bschan9228/WaterWeather/README.md

# WaterWeather
Projects involving aquariums
