bschan9228/WaterWeather/WaterTopper/README.md

# WaterTopper
WaterTopper is a device that can automatically pump liquids. Using non-contact liquid level sensors, it can pump water accordingly.

It features:
- ESP32-S3-MINI-1 microcontroller
- USB-C for programming and powering the device
- Barrel jack to power two motors through terminals
- Dual motor drivers to control peristaltic pumps
- Four JST connectors to connect non-contact liquid level sensors
- 240x320 TFT display
- External temperature sensor
- One user-programmable button
- Six user-programmable LEDs




## Schematics


## PCB Design
WaterTopper_PCB

## Current Hardware Bugs
- Display's MOSFET has the wrong pinout/footprint
- Display's connectors has the wrong size/footprint
- JST connectors have the wrong footprint

- Significant problems with motor driver not working
- Voltage divider dividing incorrectly

Thanks for UCSD Envision/Colin for making this project happen.
