bschan9228/WaterWeather/WaterTopper/Hardware/esp32s3.png

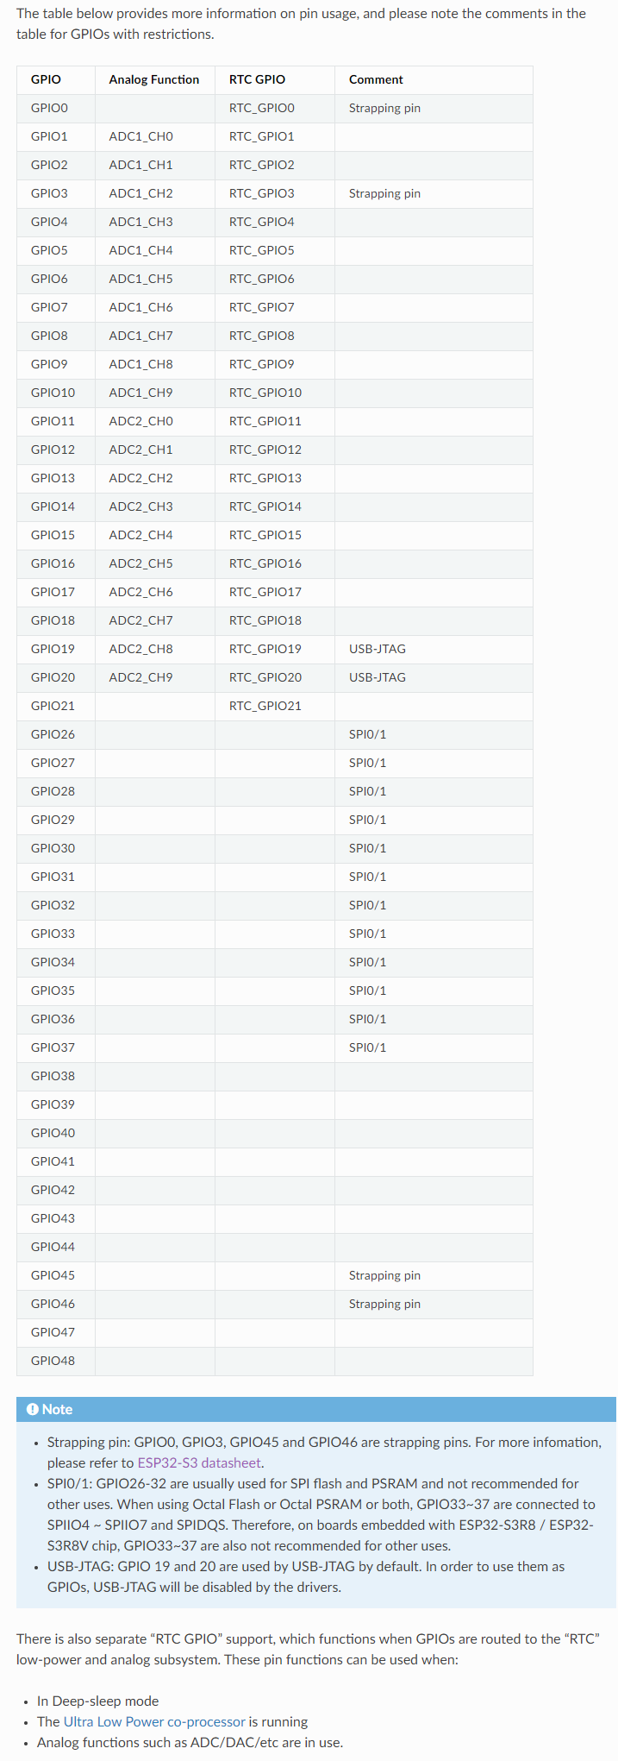
WaterTopper/Hardware/esp32s3.png
