bschan9228/WaterWeather/WaterTopper/Hardware/WaterTopper/WaterTopper.kicad_pcb

## KiCad design WaterTopper/Hardware/WaterTopper/WaterTopper.kicad_pcb (2022-11-21)

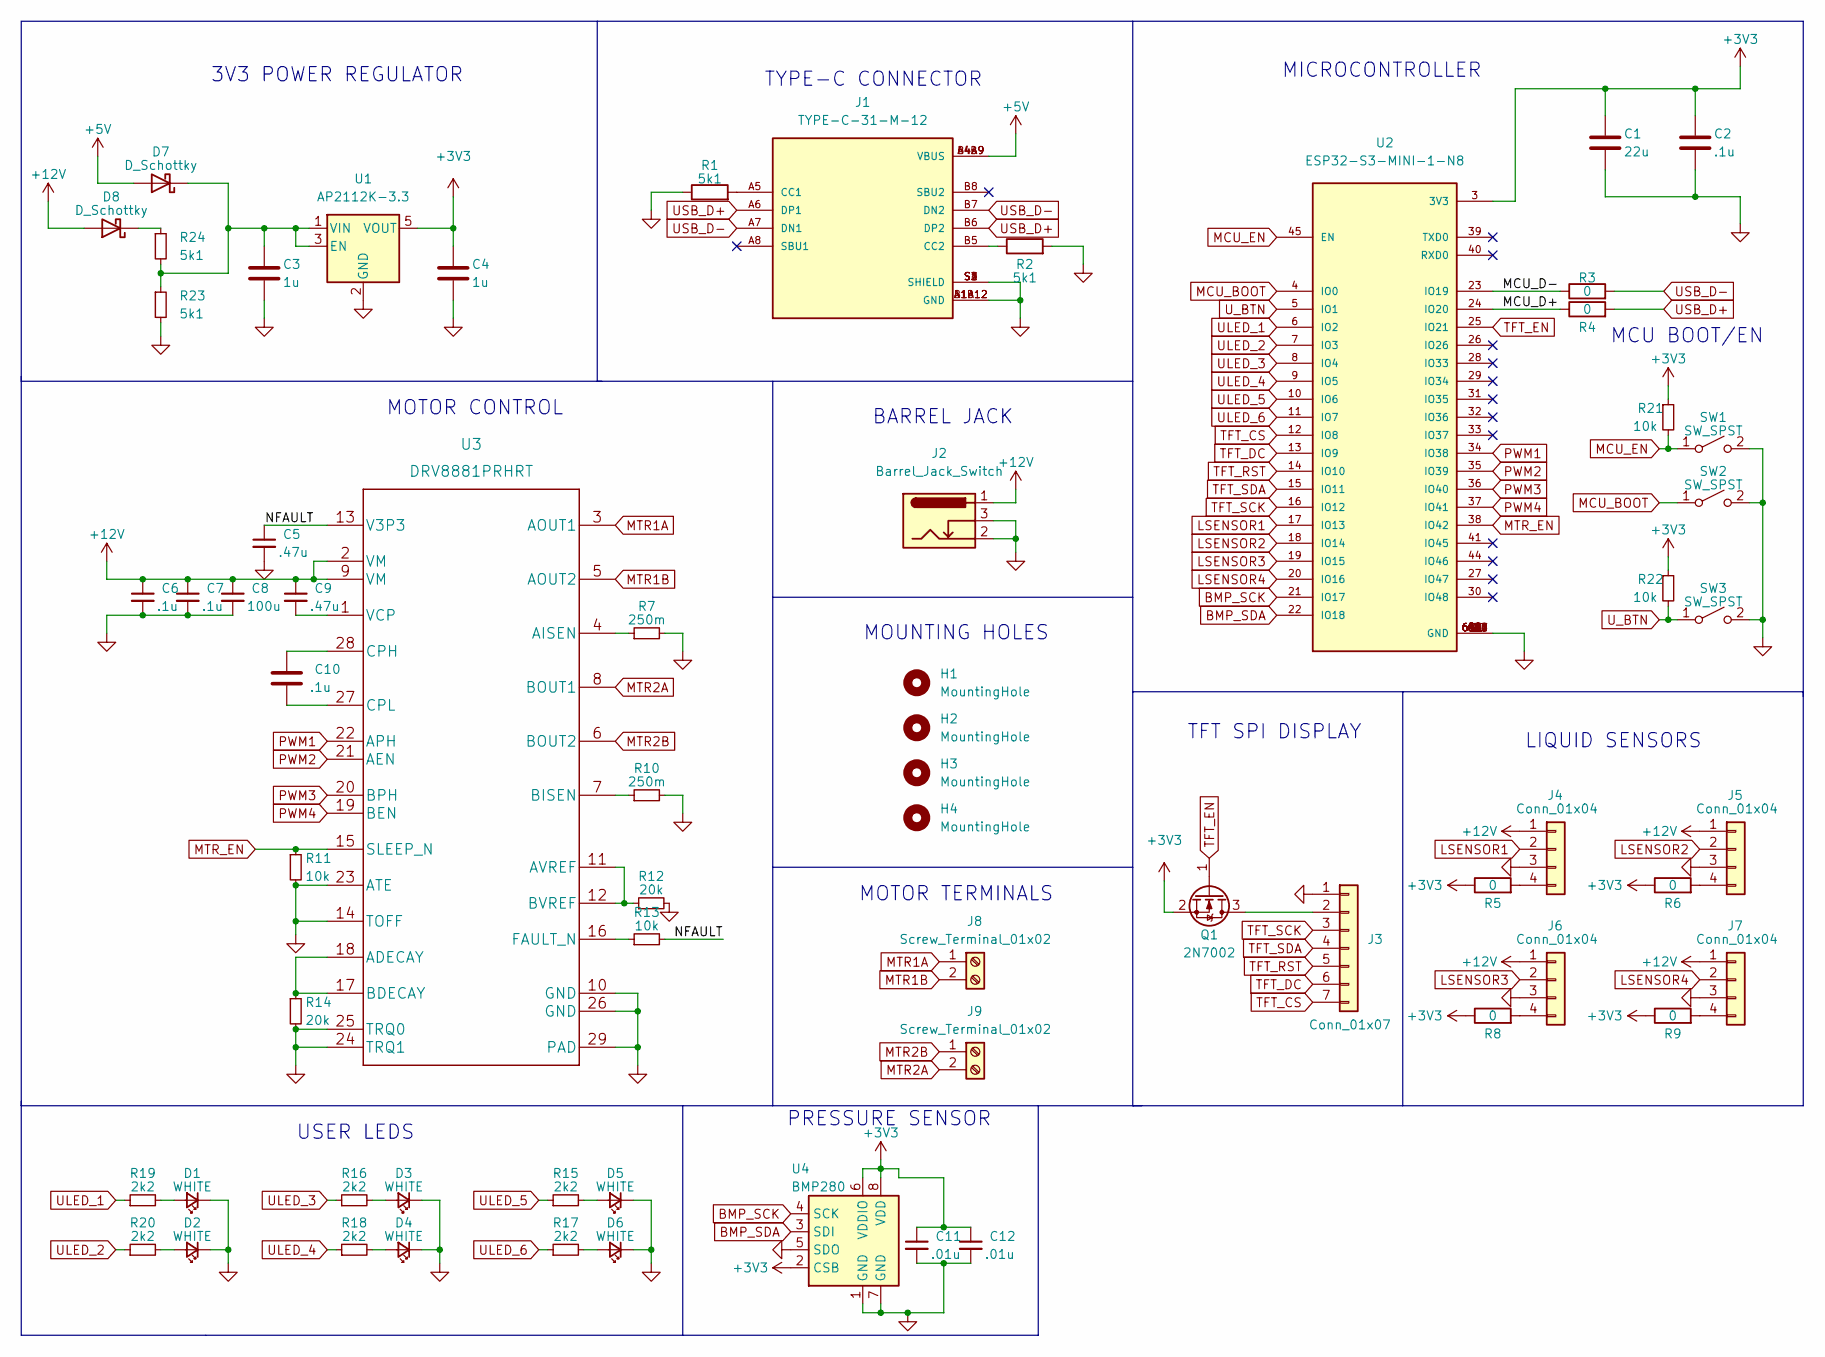
[picture p2: schematic WaterTopper.kicad_sch]

Parts:
C1: 22u; C_0805_2012Metric
C2, C6, C7, C10: .1u; C_0603_1608Metric
C3, C4: 1u; C_0805_2012Metric
C5, C9: .47u; C_0603_1608Metric
C8: 100u; C_Elec_6.3x5.8
C11, C12: .01u; C_0603_1608Metric
D1, D2, D3, D4, D5, D6: WHITE; LED_0603_1608Metric
D7, D8: D_Schottky; D_SMA
H1, H2, H3, H4: MountingHole; MountingHole_3.2mm_M3
J1: TYPE-C-31-M-12; HRO_TYPE-C-31-M-12; PARTREV A
J2: Barrel_Jack_Switch; BarrelJack_Wuerth_6941xx301002
J3: Conn_01x07; PinHeader_1x07_P2.00mm_Vertical
J4, J5, J6, J7: Conn_01x04; JST_PH_B4B-PH-K_1x04_P2.00mm_Vertical
J8, J9: Screw_Terminal_01x02; TerminalBlock_bornier-2_P5.08mm
Q1: 2N7002; SOT-23
R1, R2, R23, R24: 5k1; R_0603_1608Metric
R3, R4, R5, R6, R8, R9: 0; R_0603_1608Metric
R7, R10: 250m; R_0603_1608Metric
R11, R13, R21, R22: 10k; R_0603_1608Metric
R12, R14: 20k; R_0603_1608Metric
R15, R16, R17, R18, R19, R20: 2k2; R_0603_1608Metric
SW1, SW2: SW_SPST; SW_SPST_PTS810
SW3: SW_SPST; SW_Tactile_SPST_Angled_PTS645Vx58-2LFS
U1: AP2112K-3.3; SOT-23-5
U2: ESP32-S3-MINI-1-N8; XCVR_ESP32-S3-MINI-1-N8; PARTREV v0.6
U3: DRV8881PRHRT
U4: BMP280; Bosch_LGA-8_2x2.5mm_P0.65mm_ClockwisePinNumbering

Connections:
+3V3: C1.1, C2.1, C4.1, C11.1, C12.1, Q1.2 (S), R5.1, R6.1, R8.1, R9.1, R21.1, R22.1, U1.5 (VOUT), U2.3 (3V3), U4.2 (CSB), U4.6 (VDDIO), U4.8 (VDD)
+5V: D7.2 (A), J1.A4B9 (VBUS), J1.B4A9 (VBUS)
+12V: C6.1, C7.1, C8.1, C9.1, D8.2 (A), J2.1, J4.1, J5.1, J6.1, J7.1, U3.2 (VM), U3.9 (VM)
/MCU_D+: R4.1, U2.24 (IO20)
/MCU_D-: R3.1, U2.23 (IO19)
/NFAULT: C5.1, R13.2, U3.13 (V3P3)
BMP_SCK: U2.21 (IO17), U4.4 (SCK)
BMP_SDA: U2.22 (IO18), U4.3 (SDI)
GND: C1.2, C2.2, C3.2, C4.2, C5.2, C6.2, C7.2, C8.2, C11.2, C12.2, D1.1 (K), D2.1 (K), D3.1 (K), D4.1 (K), D5.1 (K), D6.1 (K), J1.A1B12 (GND), J1.B1A12 (GND), J1.S1 (SHIELD), J1.S2 (SHIELD), J1.S3 (SHIELD), J1.S4 (SHIELD), J2.2, J2.3, J3.1, J4.3, J5.3, J6.3, J7.3, R1.1, R2.2, R7.2, R10.2, R11.2, R12.2, R14.2, R23.2, SW1.2 (B), SW2.2 (B), SW3.2 (B), U1.2 (GND), U2.1 (GND), U2.2 (GND), U2.42 (GND), U2.43 (GND), U2.46 (GND), U2.47 (GND), U2.48 (GND), U2.49 (GND), U2.50 (GND), U2.51 (GND), U2.52 (GND), U2.53 (GND), U2.54 (GND), U2.55 (GND), U2.56 (GND), U2.57 (GND), U2.58 (GND), U2.59 (GND), U2.60 (GND), U2.61 (GND), U2.61_1 (GND), U2.61_2 (GND), U2.61_3 (GND), U2.61_4 (GND), U2.61_5 (GND), U2.61_6 (GND), U2.61_7 (GND), U2.61_8 (GND), U2.62 (GND), U2.63 (GND), U2.64 (GND), U2.65 (GND), U3.10 (GND), U3.14 (TOFF), U3.23 (ATE), U3.24 (TRQ1), U3.25 (TRQ0), U3.26 (GND), U3.29 (PAD), U3.V1, U3.V2, U3.V3, U3.V4, U4.1 (GND), U4.5 (SDO), U4.7 (GND)
LSENSOR1: J4.2, U2.17 (IO13)
LSENSOR2: J5.2, U2.18 (IO14)
LSENSOR3: J6.2, U2.19 (IO15)
LSENSOR4: J7.2, U2.20 (IO16)
MCU_BOOT: SW2.1 (A), U2.4 (IO0)
MCU_EN: R21.2, SW1.1 (A), U2.45 (EN)
MTR1A: J8.1, U3.3 (AOUT1)
MTR1B: J8.2, U3.5 (AOUT2)
MTR2A: J9.2, U3.8 (BOUT1)
MTR2B: J9.1, U3.6 (BOUT2)
MTR_EN: R11.1, U2.38 (IO42), U3.15 (SLEEP_N)
unnamed: C3.1, D7.1 (K), R23.1, R24.2, U1.1 (VIN), U1.3 (EN)
unnamed: C9.2, U3.1 (VCP)
unnamed: C10.1, U3.28 (CPH)
unnamed: C10.2, U3.27 (CPL)
unnamed: D1.2 (A), R19.2
unnamed: D2.2 (A), R20.2
unnamed: D3.2 (A), R16.2
unnamed: D4.2 (A), R18.2
unnamed: D5.2 (A), R15.2
unnamed: D6.2 (A), R17.2
unnamed: D8.1 (K), R24.1
unnamed: J1.A5 (CC1), R1.2
unnamed: J1.B5 (CC2), R2.1
unnamed: J3.2, Q1.3 (D)
unnamed: J4.4, R5.2
unnamed: J5.4, R6.2
unnamed: J6.4, R8.2
unnamed: J7.4, R9.2
unnamed: R7.1, U3.4 (AISEN)
unnamed: R10.1, U3.7 (BISEN)
unnamed: R12.1, U3.11 (AVREF), U3.12 (BVREF)
unnamed: R13.1, U3.16 (FAULT_N)
unnamed: R14.1, U3.17 (BDECAY), U3.18 (ADECAY)
PWM1: U2.34 (IO38), U3.22 (APH)
PWM2: U2.35 (IO39), U3.21 (AEN)
PWM3: U2.36 (IO40), U3.20 (BPH)
PWM4: U2.37 (IO41), U3.19 (BEN)
TFT_CS: J3.7, U2.12 (IO8)
TFT_DC: J3.6, U2.13 (IO9)
TFT_EN: Q1.1 (G), U2.25 (IO21)
TFT_RST: J3.5, U2.14 (IO10)
TFT_SCK: J3.3, U2.16 (IO12)
TFT_SDA: J3.4, U2.15 (IO11)
ULED_1: R19.1, U2.6 (IO2)
ULED_2: R20.1, U2.7 (IO3)
ULED_3: R16.1, U2.8 (IO4)
ULED_4: R18.1, U2.9 (IO5)
ULED_5: R15.1, U2.10 (IO6)
ULED_6: R17.1, U2.11 (IO7)
USB_D+: J1.A6 (DP1), J1.B6 (DP2), R4.2
USB_D-: J1.A7 (DN1), J1.B7 (DN2), R3.2
U_BTN: R22.2, SW3.1 (A), U2.5 (IO1)

Notes on the sheet:
3V3 POWER REGULATOR
LIQUID SENSORS
MCU BOOT/EN
USER LEDS
MOUNTING HOLES
MOTOR CONTROL
MOTOR TERMINALS
TFT SPI DISPLAY
BARREL JACK
PRESSURE SENSOR
TYPE-C CONNECTOR
MICROCONTROLLER

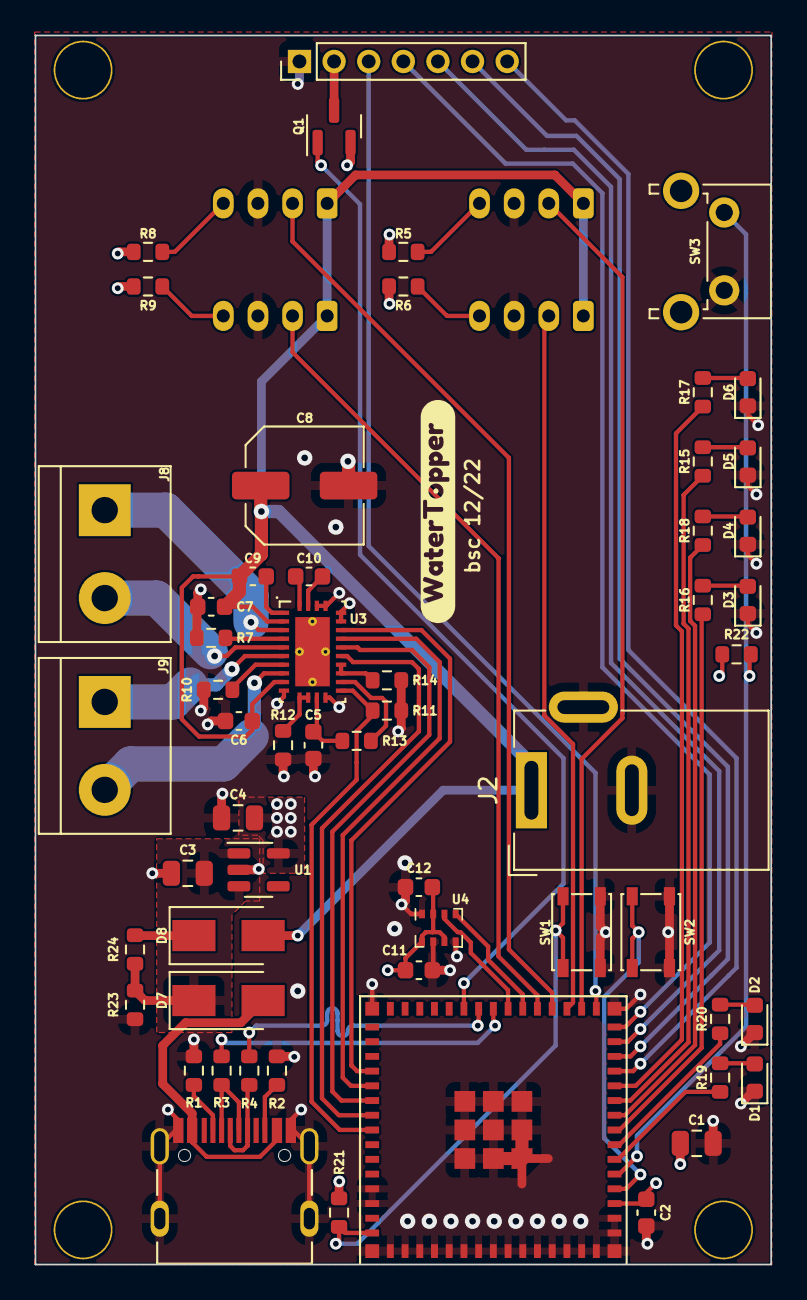
[picture p3: board WaterTopper.kicad_pcb from above]

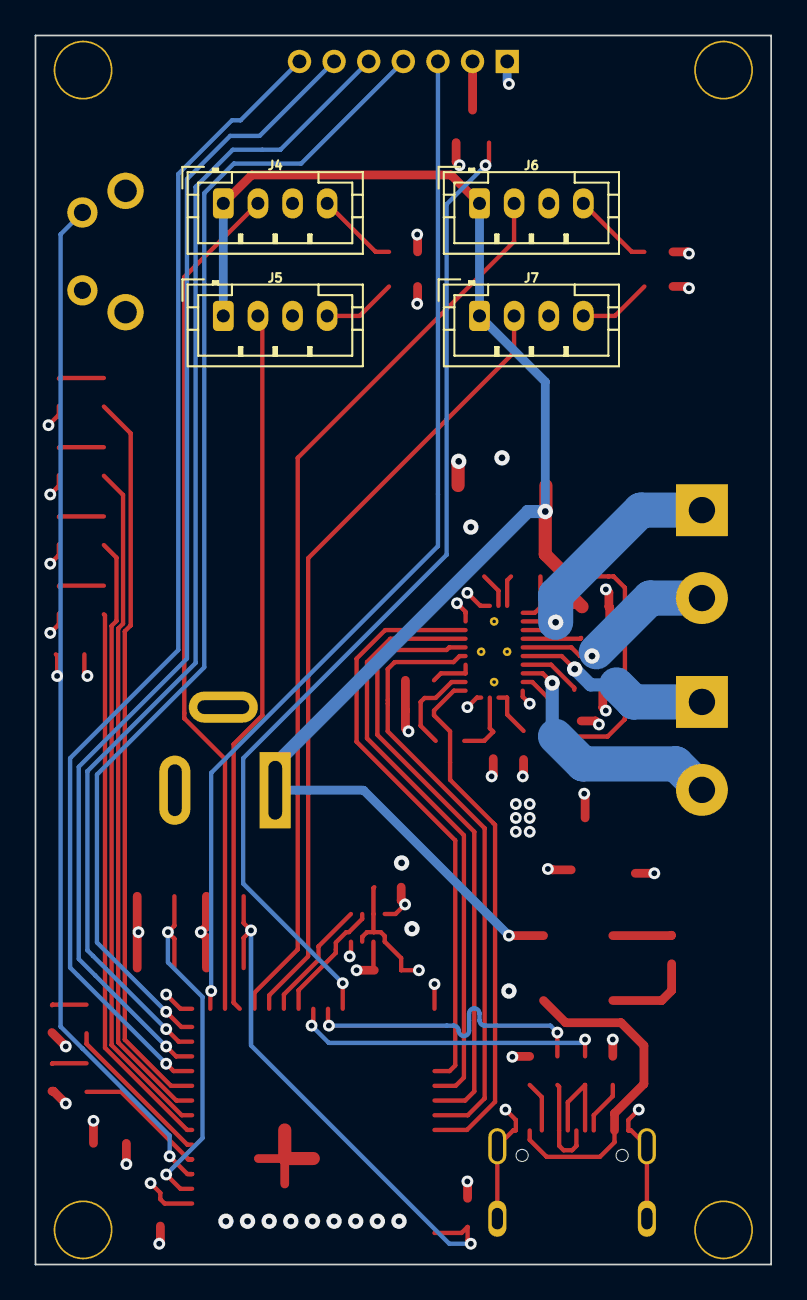
[picture p4: board WaterTopper.kicad_pcb from below]

Board: 4 copper layers, 42.5 x 71.0 mm, 66 parts (4 on the bottom side), 62 nets.

Other parts of the board:
kibuzzard-637B1446: G***; kibuzzard-637B1446
