bschan9228/WaterWeather/WaterTopper/Software/Experimental/WaterTopper_Experimental/README.md

A working system using interrupts to run the motor when the non-contact liquid detector does not detect liquids.
