bschan9228/WaterWeather/WaterTopper/Software/WaterTopper_EspIDF/main/main.c

#include <stdlib.h>

#include <esp_wifi.h>
#include <esp_event.h>
#include <esp_log.h>
#include <esp_system.h>
#include <nvs_flash.h>
#include <sys/param.h>
#include "esp_netif.h"
#include "esp_eth.h"
#include "protocol_examples_common.h"

#include <esp_http_server.h>
#include "driver/temperature_sensor.h"
#include "driver/gpio.h"

extern const char root_start[] asm("_binary_root_html_start");
extern const char root_end[] asm("_binary_root_html_end");

extern const char root_js_start[] asm("_binary_root_js_start");
extern const char root_js_end[] asm("_binary_root_js_end");

static const size_t max_clients = 16;

// ================================ RTOS ================================ //
static void led_blink()
{
    gpio_reset_pin(GPIO_NUM_14);
    gpio_set_direction(GPIO_NUM_14, GPIO_MODE_OUTPUT);
    gpio_set_level(GPIO_NUM_14, 1);

    // for (;;)
    // {
    //     gpio_set_level(GPIO_NUM_14, 1);
    // }
    while (1)
    {
        gpio_set_level(GPIO_NUM_14, 1);
        vTaskDelay(1000 / portTICK_PERIOD_MS);
        gpio_set_level(GPIO_NUM_14, 0);
        vTaskDelay(1000 / portTICK_PERIOD_MS);
    }
}

// == TEMPERATURE == //

temperature_sensor_handle_t temp_handle = NULL;
temperature_sensor_config_t temp_sensor = {
    .range_min = 20,
    .range_max = 50,
};
float temperature;

// ======================================================= =============== ======================================================= //
// ======================================================= WEBSOCKET BEGIN ======================================================= //
// ======================================================= =============== ======================================================= //

/* A simple example that demonstrates using websocket echo server
 */
static const char *TAG = "ws_echo_server";

/*
 * Structure holding server handle
 * and internal socket fd in order
 * to use out of request send
 */
struct async_resp_arg
{
    httpd_handle_t hd;
    int fd;
};

/*
 * async send function, which we put into the httpd work queue
 */

static void update_temperature()
{
    // Enable temperature sensor
    ESP_ERROR_CHECK(temperature_sensor_enable(temp_handle));
    // Get converted sensor data
    float tsens_out;
    ESP_ERROR_CHECK(temperature_sensor_get_celsius(temp_handle, &tsens_out));
    // printf("Temperature in %f °C\n", tsens_out);
    // Disable the temperature sensor if it's not needed and save the power
    ESP_ERROR_CHECK(temperature_sensor_disable(temp_handle));

    temperature = tsens_out;
}

static void send_temperature(void *arg)
{
    static char data[128];

    snprintf(data, sizeof data, "%f", temperature);
    strcat(data, ",temperature");

    struct async_resp_arg *resp_arg = arg;
    httpd_handle_t hd = resp_arg->hd;
    int fd = resp_arg->fd;
    httpd_ws_frame_t ws_pkt;
    memset(&ws_pkt, 0, sizeof(httpd_ws_frame_t));
    ws_pkt.payload = (uint8_t *)data;
    ws_pkt.len = strlen(data);
    ws_pkt.type = HTTPD_WS_TYPE_TEXT;

    httpd_ws_send_frame_async(hd, fd, &ws_pkt);
    free(resp_arg);
}

// TODO

static void send_hello(void *arg)
{
    static const char *data = "Hello client";
    struct async_resp_arg *resp_arg = arg;
    httpd_handle_t hd = resp_arg->hd;
    int fd = resp_arg->fd;
    httpd_ws_frame_t ws_pkt;
    memset(&ws_pkt, 0, sizeof(httpd_ws_frame_t));
    ws_pkt.payload = (uint8_t *)data;
    ws_pkt.len = strlen(data);
    ws_pkt.type = HTTPD_WS_TYPE_TEXT;

    httpd_ws_send_frame_async(hd, fd, &ws_pkt);
    free(resp_arg);
}

// Get all clients and send async message
static void wss_server_send_messages(httpd_handle_t *server)
{
    bool send_messages = true;

    // Send async message to all connected clients that use websocket protocol every 10 seconds
    while (send_messages)
    {
        vTaskDelay(5000 / portTICK_PERIOD_MS);

        if (!*server)
        { // httpd might not have been created by now
            continue;
        }
        size_t clients = max_clients;
        int client_fds[max_clients];
        if (httpd_get_client_list(*server, &clients, client_fds) == ESP_OK)
        {
            update_temperature();
            for (size_t i = 0; i < clients; ++i)
            {
                int sock = client_fds[i];
                if (httpd_ws_get_fd_info(*server, sock) == HTTPD_WS_CLIENT_WEBSOCKET)
                {
                    ESP_LOGI(TAG, "Active client (fd=%d) -> sending async message", sock);
                    struct async_resp_arg *resp_arg = malloc(sizeof(struct async_resp_arg));
                    resp_arg->hd = *server;
                    resp_arg->fd = sock;
                    if (httpd_queue_work(resp_arg->hd, send_temperature, resp_arg) != ESP_OK)
                    {
                        ESP_LOGE(TAG, "httpd_queue_work failed!");
                        // send_messages = false;
                        break;
                    }
                }
            }
        }
        else
        {
            ESP_LOGE(TAG, "httpd_get_client_list failed!");
            return;
        }
    }
}

static esp_err_t trigger_async_send(httpd_handle_t handle, httpd_req_t *req)
{
    struct async_resp_arg *resp_arg = malloc(sizeof(struct async_resp_arg));
    resp_arg->hd = req->handle;
    resp_arg->fd = httpd_req_to_sockfd(req);
    printf("%p", &handle);
    return httpd_queue_work(handle, send_hello, resp_arg);
}

/*
 * This handler echos back the received ws data
 * and triggers an async send if certain message received
 */
static esp_err_t echo_handler(httpd_req_t *req)
{
    if (req->method == HTTP_GET)
    {
        ESP_LOGI(TAG, "Handshake done, the new connection was opened");
        return ESP_OK;
    }
    httpd_ws_frame_t ws_pkt;
    uint8_t *buf = NULL;
    memset(&ws_pkt, 0, sizeof(httpd_ws_frame_t));
    ws_pkt.type = HTTPD_WS_TYPE_TEXT;
    /* Set max_len = 0 to get the frame len */
    esp_err_t ret = httpd_ws_recv_frame(req, &ws_pkt, 0);
    if (ret != ESP_OK)
    {
        ESP_LOGE(TAG, "httpd_ws_recv_frame failed to get frame len with %d", ret);
        return ret;
    }
    ESP_LOGI(TAG, "frame len is %d", ws_pkt.len);
    if (ws_pkt.len)
    {
        /* ws_pkt.len + 1 is for NULL termination as we are expecting a string */
        buf = calloc(1, ws_pkt.len + 1);
        if (buf == NULL)
        {
            ESP_LOGE(TAG, "Failed to calloc memory for buf");
            return ESP_ERR_NO_MEM;
        }
        ws_pkt.payload = buf;
        /* Set max_len = ws_pkt.len to get the frame payload */
        ret = httpd_ws_recv_frame(req, &ws_pkt, ws_pkt.len);
        if (ret != ESP_OK)
        {
            ESP_LOGE(TAG, "httpd_ws_recv_frame failed with %d", ret);
            free(buf);
            return ret;
        }
        ESP_LOGI(TAG, "Got packet with message: %s", ws_pkt.payload);
    }
    ESP_LOGI(TAG, "Packet type: %d", ws_pkt.type);
    if (ws_pkt.type == HTTPD_WS_TYPE_TEXT &&
        strcmp((char *)ws_pkt.payload, "blink") == 0)
    {
        free(buf);

        xTaskCreate(led_blink, "Blinkly", 4096, NULL, 1, NULL);
        return ret;
        // return trigger_async_send(req->handle, req);
    }
    if (ws_pkt.type == HTTPD_WS_TYPE_TEXT &&
        strcmp((char *)ws_pkt.payload, "temperature") == 0)
    {
        free(buf);
        return trigger_async_send(req->handle, req);
    }
    ret = httpd_ws_send_frame(req, &ws_pkt);
    if (ret != ESP_OK)
    {
        ESP_LOGE(TAG, "httpd_ws_send_frame failed with %d", ret);
    }
    free(buf);
    return ret;
}

static const httpd_uri_t ws = {
    .uri = "/ws",
    .method = HTTP_GET,
    .handler = echo_handler,
    .user_ctx = NULL,
    .is_websocket = true};

// ======================================================= =============== ======================================================= //
// ======================================================= ROOT PAGE BEGIN ======================================================= //
// ======================================================= =============== ======================================================= //

// /* An HTTP GET handler */
// static esp_err_t root_get_handler(httpd_req_t *req)
// {
//     /* Send response with custom headers and body set as the
//      * string passed in user context*/
//     const char resp[] = "Example GET Response";
//     httpd_resp_send(req, resp, HTTPD_RESP_USE_STRLEN);
//     return ESP_OK;
// }

static esp_err_t root_get_handler(httpd_req_t *req)
{
    const uint32_t root_len = root_end - root_start;

    ESP_LOGI(TAG, "Serve root");
    httpd_resp_set_type(req, "text/html");
    httpd_resp_send(req, root_start, root_len);

    return ESP_OK;
}

static const httpd_uri_t root = {
    .uri = "/",
    .method = HTTP_GET,
    .handler = root_get_handler,
    /* Let's pass response string in user
     * context to demonstrate it's usage */
    .user_ctx = NULL};

// ======================================================= ============= ======================================================= //
// ======================================================= ROOT PAGE END ======================================================= //
// ======================================================= ============= ======================================================= //

// ======================================================= ================== ======================================================= //
// ======================================================= ROOT.JS PAGE BEGIN ======================================================= //
// ======================================================= ================== ======================================================= //
static esp_err_t root_js_get_handler(httpd_req_t *req)
{
    const uint32_t root_js_len = root_js_end - root_js_start;

    ESP_LOGI(TAG, "Serve root");
    httpd_resp_set_type(req, "text/html");
    httpd_resp_send(req, root_js_start, root_js_len);

    return ESP_OK;
}

static const httpd_uri_t root_js = {
    .uri = "/root.js",
    .method = HTTP_GET,
    .handler = root_js_get_handler,
    /* Let's pass response string in user
     * context to demonstrate it's usage */
    .user_ctx = NULL};

// ======================================================= ================ ======================================================= //
// ======================================================= ROOT.JS PAGE END ======================================================= //
// ======================================================= ================ ======================================================= //

static httpd_handle_t start_webserver(void)
{
    httpd_handle_t server = NULL;
    httpd_config_t config = HTTPD_DEFAULT_CONFIG();

    // Start the httpd server
    ESP_LOGI(TAG, "Starting server on port: '%d'", config.server_port);
    if (httpd_start(&server, &config) == ESP_OK)
    {
        // Registering the ws handler
        ESP_LOGI(TAG, "Registering URI handlers");
        httpd_register_uri_handler(server, &root);
        httpd_register_uri_handler(server, &root_js);
        httpd_register_uri_handler(server, &ws);
        return server;
    }

    ESP_LOGI(TAG, "Error starting server!");
    return NULL;
}

static esp_err_t stop_webserver(httpd_handle_t server)
{
    // Stop the httpd server
    return httpd_stop(server);
}

static void disconnect_handler(void *arg, esp_event_base_t event_base,
                               int32_t event_id, void *event_data)
{
    httpd_handle_t *server = (httpd_handle_t *)arg;
    if (*server)
    {
        ESP_LOGI(TAG, "Stopping webserver");
        if (stop_webserver(*server) == ESP_OK)
        {
            *server = NULL;
        }
        else
        {
            ESP_LOGE(TAG, "Failed to stop http server");
        }
    }
}

static void connect_handler(void *arg, esp_event_base_t event_base,
                            int32_t event_id, void *event_data)
{
    httpd_handle_t *server = (httpd_handle_t *)arg;
    if (*server == NULL)
    {
        ESP_LOGI(TAG, "Starting webserver");
        *server = start_webserver();
    }
}

void app_main(void)
{
    static httpd_handle_t server = NULL;

    ESP_ERROR_CHECK(nvs_flash_init());
    ESP_ERROR_CHECK(esp_netif_init());
    ESP_ERROR_CHECK(esp_event_loop_create_default());

    /* This helper function configures Wi-Fi or Ethernet, as selected in menuconfig.
     * Read "Establishing Wi-Fi or Ethernet Connection" section in
     * examples/protocols/README.md for more information about this function.
     */
    ESP_ERROR_CHECK(example_connect());

    /* Register event handlers to stop the server when Wi-Fi or Ethernet is disconnected,
     * and re-start it upon connection.
     */
#ifdef CONFIG_EXAMPLE_CONNECT_WIFI
    ESP_ERROR_CHECK(esp_event_handler_register(IP_EVENT, IP_EVENT_STA_GOT_IP, &connect_handler, &server));
    ESP_ERROR_CHECK(esp_event_handler_register(WIFI_EVENT, WIFI_EVENT_STA_DISCONNECTED, &disconnect_handler, &server));
#endif // CONFIG_EXAMPLE_CONNECT_WIFI
#ifdef CONFIG_EXAMPLE_CONNECT_ETHERNET
    ESP_ERROR_CHECK(esp_event_handler_register(IP_EVENT, IP_EVENT_ETH_GOT_IP, &connect_handler, &server));
    ESP_ERROR_CHECK(esp_event_handler_register(ETH_EVENT, ETHERNET_EVENT_DISCONNECTED, &disconnect_handler, &server));
#endif // CONFIG_EXAMPLE_CONNECT_ETHERNET

    /* Start the server for the first time */
    server = start_webserver();

    ESP_ERROR_CHECK(temperature_sensor_install(&temp_sensor, &temp_handle));

    printf("========================= BROADCASTING =========================");
    xTaskCreate(wss_server_send_messages, "Websocket Updater", 2048, &server, 1, NULL);
    // xTaskCreate(led_blink, "Blinkly", 4096, NULL, 1, NULL);
}
