bschan9228/WaterWeather/(commit log)

2022-11-13 Added code for motor control/sensors/display
2022-11-18 Updated and added more parts to schematics
    [WaterTopper.kicad_pcb, WaterTopper.kicad_sch]
2022-11-20 Finished WaterTopper schematic
    [WaterTopper.kicad_pcb, WaterTopper.kicad_sch]
2022-11-20 Updated pcb design
    [WaterTopper.kicad_pcb, WaterTopper.kicad_sch]
2022-11-21 Updated pcb + 4 layer
    [WaterTopper.kicad_pcb, WaterTopper.kicad_sch]
2022-11-21 Completed pcb v0.1
    [WaterTopper.kicad_pcb, WaterTopper.kicad_sch]
2022-11-21 Added/fixed silkscreen
    [WaterTopper.kicad_pcb]
2022-11-21 Added small fixes + transistor for display
    [WaterTopper.kicad_pcb]
2022-11-21 Added button
    [WaterTopper.kicad_pcb, WaterTopper.kicad_sch]
2022-11-21 Added BOM, added voltage divider
    [WaterTopper-B_Mask.gbr, WaterTopper-B_Paste.gbr, WaterTopper-B_Silkscreen.gbr, WaterTopper-Back.gbr, WaterTopper-Edge_Cuts.gbr, WaterTopper-F_Mask.gbr, WaterTopper-F_Paste.gbr, WaterTopper-F_Silkscreen.gbr]
2022-12-05 Added bom
2022-12-12 Built small motor driver library
    [WaterTopper.kicad_sch]
2022-12-12 Made small motor driver library
2022-12-13 Implemented motor driver interrupts
